crankery/tantricyphons/hw/fp/fp.dxf/fp-Edge_Cuts.dxf

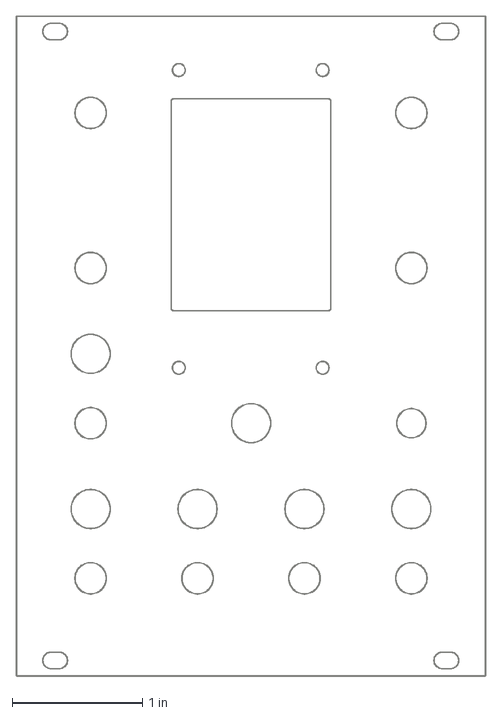
[picture p1: CAD file, 2026-11-01]
hw/fp/fp.dxf/fp-Edge_Cuts.dxf
3.60 x 5.06 in
