crankery/tantricyphons/src/tantricyphons/include/controls/ui_controls.h

#ifndef TANTRICYPHONS_UI_CONTROLS_H
#define TANTRICYPHONS_UI_CONTROLS_H
#include <stdint.h>

#define ENCODER_A 16
#define ENCODER_B 17
#define ENCODER_SW 18
#define BACK_SW 19

/* PIO2 counts GP16/17 edges. Active-low OK/Back use pull-ups and debounce.
 * Four quadrature edges per detent; see encoder_steps.h. */
void ui_controls_init(void);
void ui_controls_poll(void);
/* Last sampled cumulative PIO edge count, core 0 only. */
uint32_t ui_controls_encoder_count(void);

#endif
