crankery/tantricyphons/(commit log)

2026-11-01 add a little usb serial console for testing without full hardware
    [fp-Edge_Cuts.dxf]
2026-11-01 remove prototype project
    [lamarama.kicad_pcb, lamarama.kicad_sch]
